xingdeshoumin/darts_-v1.2/README.assets/1815493-20191011175632763-327473720.png

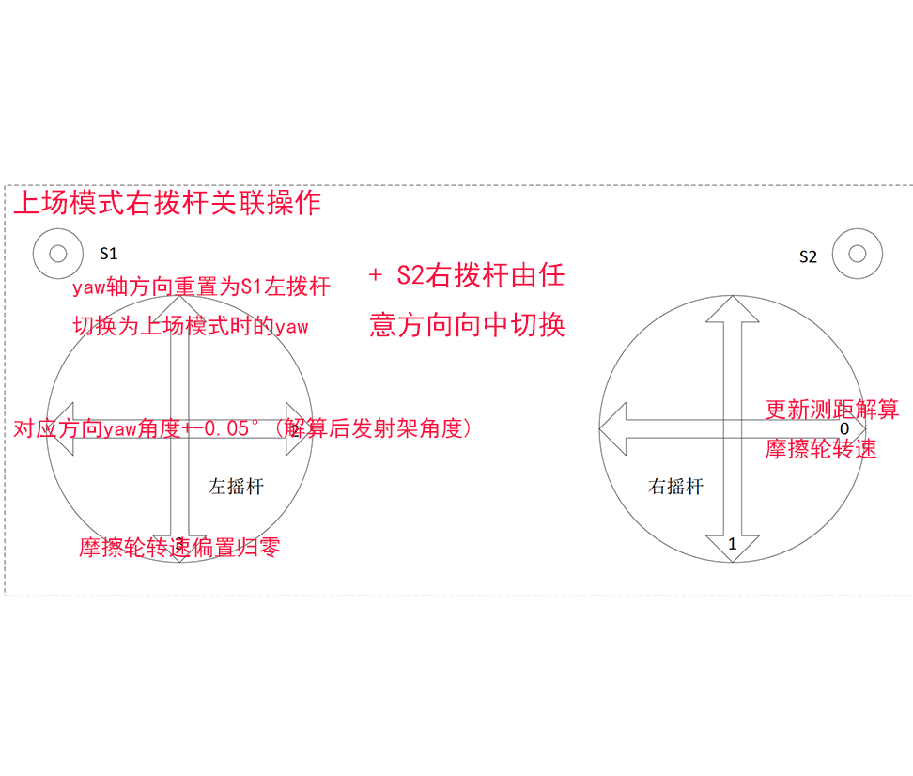
README.assets/1815493-20191011175632763-327473720.png
