xingdeshoumin/darts_-v1.2/updatelogs.assets/IMG_0369.jpeg

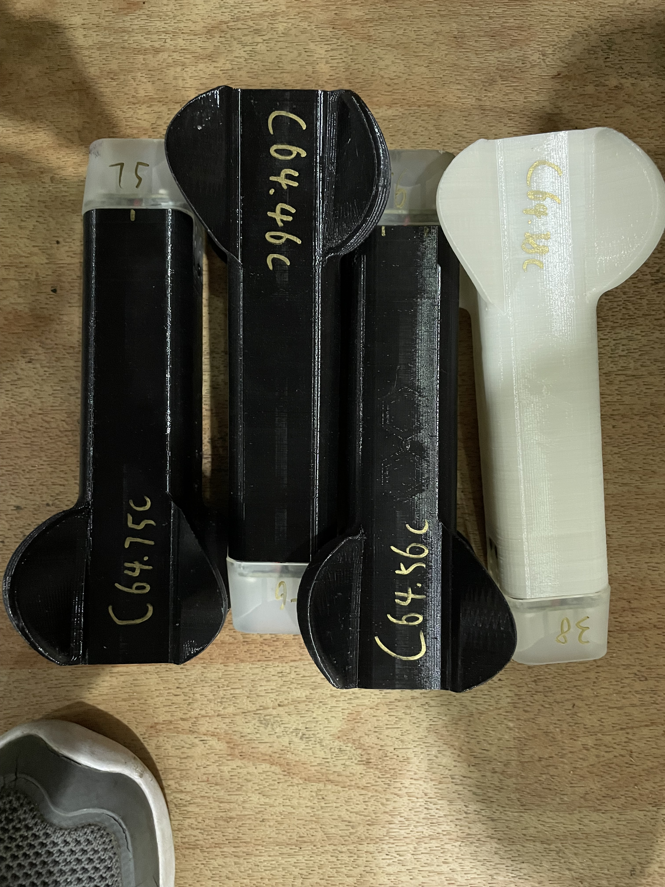
updatelogs.assets/IMG_0369.jpeg
