xingdeshoumin/darts_-v1.2/DARTS_V1.0.ioc

Mcu.UserName=STM32F427IIHx
PA13.Signal=SYS_JTMS-SWDIO
PA14.Signal=SYS_JTCK-SWCLK
PA7.Signal=SPI1_MOSI
PB10.Signal=GPIO_Output
PB3.Signal=SPI1_SCK
PB5.Signal=S_TIM3_CH2
PB6.Signal=USART1_TX
PB7.Signal=USART1_RX
PB8.GPIO_Label=IMU_INT
PB8.Signal=GPXTI8
PB9.Signal=GPIO_Output
PC10.Signal=SDIO_D2
PC11.Signal=SDIO_D3
PC12.Signal=SDIO_CK
PC8.Signal=SDIO_D0
PC9.Signal=SDIO_D1
PD0.Signal=CAN1_RX
PD1.Signal=CAN1_TX
PD2.Signal=SDIO_CMD
PD8.Signal=USART3_TX
PD9.Signal=USART3_RX
PE11.Signal=GPIO_Output
PE7.Signal=UART7_RX
PE8.Signal=UART7_TX
PF0.Signal=GPIO_Output
PF1.Signal=GPIO_Output
PF10.Signal=GPIO_Output
PF14.Signal=GPIO_Output
PF6.Signal=GPIO_Output
PF7.Signal=SPI5_SCK
PF8.Signal=SPI5_MISO
PF9.Signal=SPI5_MOSI
PG1.Signal=GPIO_Output
PG13.Signal=GPIO_Output
PG14.Signal=USART6_TX
PG2.Signal=GPIO_Output
PG3.Signal=GPIO_Output
PG4.Signal=GPIO_Output
PG5.Signal=GPIO_Output
PG6.Signal=GPIO_Output
PG7.Signal=GPIO_Output
PG8.Signal=GPIO_Output
PG9.Signal=USART6_RX
PH0/OSC_IN.Signal=RCC_OSC_IN
PH1/OSC_OUT.Signal=RCC_OSC_OUT
PH2.Signal=GPIO_Output
PH3.Signal=GPIO_Output
PH4.Signal=GPIO_Output
PH5.Signal=GPIO_Output
PI2.Signal=GPXTI2
PI9.Signal=GPIO_Output
