xingdeshoumin/darts_-v1.2/Packages/control/chassis_control.c

#include "chassis_control.h"
#include "string.h"
#include "chassis_behavior.h"
#include "bsp_dubs.h"
#include "STMGood.h"
#include "math.h"
#include "target_finder.h"

float F_P=10,F_I=6.0,F_D=0.5;//摩擦轮PID P：6~10
float F_F=0.012; // 摩擦轮前馈
float YAW_F = 0.1; // yaw前馈
float tmp_correct;


s_pid_absolute_t  MOTOR_S_PID= {0};
s_pid_absolute_t  MOTOR_P_PID = {0};

s_pid_absolute_t  YAW_S_PID= {0};
s_pid_absolute_t  YAW_P_PID = {0};

s_pid_absolute_t  PITCH_S_PID= {0};
s_pid_absolute_t  PITCH_P_PID = {0};

s_pid_absolute_t  FIRE_L_S_PID= {0};

s_pid_absolute_t  FIRE_R_S_PID= {0};

s_pid_absolute_t  DEVIATION_PID= {0};

motor_data_t motor = {0};
motor_data_t yaw = {0};
motor_data_t pitch = {0};
motor_data_t fire_r = {0};
motor_data_t fire_l = {0};

int16_t deviation_out = 0;

void chassis_control_loop_init(void)
{
  	memset(&motor , 0 ,sizeof(motor_data_t));
	memset(&pitch , 0 ,sizeof(motor_data_t));
	memset(&yaw , 0 ,sizeof(motor_data_t));
	memset(&fire_l , 0 ,sizeof(motor_data_t));
	memset(&fire_r , 0 ,sizeof(motor_data_t));
	
	pid_abs_param_init(&MOTOR_S_PID,0,0,0,20000.0f,16000.0f);
	pid_abs_param_init(&MOTOR_P_PID,0,0,0,0.0f,4000.0f);
	
	pid_abs_param_init(&PITCH_S_PID,0,0,0,20000.0f,16000.0f);
	pid_abs_param_init(&PITCH_P_PID,0,0,0,0.0f,4000.0f);
	
	pid_abs_param_init(&YAW_S_PID,0,0,0,20000.0f,28000.0f);
	pid_abs_param_init(&YAW_P_PID,0,0,0,0.0f,400.0f);
	
	pid_abs_param_init(&FIRE_L_S_PID,0,0,0,20000.0f,16000.0f);

	pid_abs_param_init(&FIRE_R_S_PID,0,0,0,20000.0f,16000.0f);

	pid_abs_param_init(&DEVIATION_PID,0,0,0,20000.0f,28000.0f);
}

void chassis_control_loop_reset(void)
{ 
	
	pid_abs_param_init(&MOTOR_S_PID,13,0,0,3000.0f,8000.0f);
	pid_abs_param_init(&MOTOR_P_PID,0.8,0.01,0,0.0f,4000.0f);
	
	pid_abs_param_init(&PITCH_S_PID,9,0.3,0,20000.0f,16000.0f);
	pid_abs_param_init(&PITCH_P_PID,0.5,0.1,0,0.0f,4000.0f);
	
	pid_abs_param_init(&YAW_S_PID,60,10,0,20000.0f,28000.0f);
	pid_abs_param_init(&YAW_P_PID,5,80,0,0.0f,28000.0f);
    // pid_abs_param_init(&YAW_P_PID,5,0,0,0.0f,28000.0f);
	
	pid_abs_param_init(&FIRE_L_S_PID,F_P,F_I,F_D,20000.0f,16000.0f);

	pid_abs_param_init(&FIRE_R_S_PID,F_P,F_I,F_D,20000.0f,16000.0f);
	
	pid_abs_param_init(&DEVIATION_PID,60,0,0,20000.0f,28000.0f);
}


void chassis_motor_control_loop_pid_control(void)
{
	// YL.num += YL_error_correction(YL.num);
	YL.num = fmaxf(YL.num, (-9.71 * REDUCTION_RATIO_WHEEL / 360.0f * 8192.0f + GIMBAL_OFFSET));
	YL.num = fminf(YL.num, (10.61 * REDUCTION_RATIO_WHEEL / 360.0f * 8192.0f + GIMBAL_OFFSET));
	// tmp_correct = FL_error_correction();

	motor.target_position = LL.num;
	pitch.target_position = PL.num;
	yaw.target_position = YL.num;
	fire_l.target_speed = FL.V + tmp_correct;
	fire_r.target_speed = -FL.V - tmp_correct;
	
	MOTOR_P_PID.NowError = motor.target_position - motor.serial_position;
	PITCH_P_PID.NowError =pitch.target_position - pitch.serial_position;

    yaw.filted_position = (1.0f - POSITION_SMOOTH_COEF) * yaw.filted_position + POSITION_SMOOTH_COEF * yaw.serial_position;

	YAW_P_PID.NowError = yaw.target_position - yaw.filted_position;

    fire_l.average_speed = (1.0f - SPEED_SMOOTH_COEF) * fire_l.average_speed + SPEED_SMOOTH_COEF * fire_l.esc_back_speed;
    fire_r.average_speed = (1.0f - SPEED_SMOOTH_COEF) * fire_r.average_speed + SPEED_SMOOTH_COEF * fire_r.esc_back_speed;
    
	FIRE_L_S_PID.NowError = fire_l.target_speed - fire_l.average_speed;
	FIRE_R_S_PID.NowError = fire_r.target_speed - fire_r.average_speed;
	
	PID_AbsoluteMode(&MOTOR_P_PID);
	PID_AbsoluteMode(&PITCH_P_PID);
	PID_AbsoluteMode(&YAW_P_PID);
	
	PID_AbsoluteMode(&FIRE_L_S_PID);
	PID_AbsoluteMode(&FIRE_R_S_PID);
	
	MOTOR_S_PID.NowError = MOTOR_P_PID.PIDout - motor.esc_back_speed;
	PITCH_S_PID.NowError = PITCH_P_PID.PIDout - pitch.esc_back_speed;
	YAW_S_PID.NowError = YAW_P_PID.PIDout - yaw.esc_back_speed;
	
	PID_AbsoluteMode(&MOTOR_S_PID);
	PID_AbsoluteMode(&PITCH_S_PID);
	PID_AbsoluteMode(&YAW_S_PID);
	
	motor.out_current = MOTOR_S_PID.PIDout;
	pitch.out_current = PITCH_S_PID.PIDout;
	yaw.out_current = YAW_S_PID.PIDout;
	fire_l.out_current = FIRE_L_S_PID.PIDout + F_F * fire_l.target_speed;
	fire_r.out_current = FIRE_R_S_PID.PIDout - F_F * fire_r.target_speed;
}

float YL_error_correction(float YL)
{
	static float last_YL;
	static int last_YL_direction_flag;
	static int last_YL_Init_flag;
	static int YL_direction_flag;
	float back_num = 0;

	if (last_YL_Init_flag == 0)
	{
		last_YL = YL;
		last_YL_Init_flag = 1;
	}
	
	if ((YL - last_YL) > 0)
	{
		YL_direction_flag = 1;
	}
	else if ((YL - last_YL) < 0)
	{
		YL_direction_flag = 0;
	}
	if (YL_direction_flag > last_YL_direction_flag)
	{
		back_num = 60.0;
	}
	else if (YL_direction_flag < last_YL_direction_flag)
	{
		back_num = -60.0;
	}
	
	last_YL = YL;
	last_YL_direction_flag = YL_direction_flag;

	return back_num;
}

/*进行摩擦轮补偿的思想是，摩擦轮转速只减不加，由于机械做的十分优秀，在固定温度下给摩擦轮固定转速打出的弹速是一个很标准的正态分布，
（所以这是前提）所以做了这个效果还不错，但是不做纯粹的每个温度对应多少摩擦轮转速的原因是，恒定摩擦轮转速下，温度对应弹速并非是简单一
次线性，所以需要多次测试去整定超参数，为什么要只减不加呢，因为如果做的是完全的线性，那么有可能出现温度降下来后超射速，也造成了每辆车
可能由于机械精度不同，每辆车的公式要重新整定，十分麻烦（毕竟调参要更简单），也可以避免由于机械误差导致弹速不稳定，给了机械一个余量*/

// 猜测温度变化造成转速变化有可能是温度上升导致霍尔编码器灵敏度增高， 返回速度略微增大， 经过环路计算后， 实际转速减小
float FL_error_correction(void)
{
    // float return_num = (40.0f - (fire_l.esc_back_temperature + fire_r.esc_back_temperature) * 0.5f) / 15.0f * 50.0f;
    float return_num = ((fire_l.esc_back_temperature + fire_r.esc_back_temperature) * 0.5f - 29.0f) / 6.0f * 30.0f;
	return_num = fminf(return_num, 120.0f);
	return_num = fmaxf(return_num, -120.0f);
	return return_num;
}
