xingdeshoumin/darts_-v1.2/Packages/Free_Task/motorTask.c

////////////////////////////////////////////////////////////////
//2022.6.16更新
//飞镖问题及优化方向：1.摩擦轮脱胶 2.摩擦轮温度对飞镖速度的闭环没做 
//3.没做数据存储与应用（flash等） 4.飞镖架稳定性（摩擦轮除抖等）
//5.yaw轴小齿大齿周向增设预紧力消除减小齿隙 6.飞镖做开关及充电口
////////////////////////////////////////////////////////////////
// 15962
// 25439

#include "cmsis_os.h"
#include "chassis_control.h"
#include "chassis_behavior.h"
#include "bsp_can.h"
#include "bsp_dubs.h"
#include "bsp_flash.h"


void Startmotor_task(void const * argument)
{
  /* USER CODE BEGIN Startmotor_task */

	chassis_control_loop_init();
  /* Infinite loop */
	
	osDelay(6000);//等can中断
	// 6020返值bug
	YL.num=yaw.serial_position*1.0f;
	LL.num=motor.serial_position*1.0f;
	PL.num=pitch.esc_back_position*1.0f;

	// uint32_t *message;
	// flash_read(0x080E000,message,2);
	
  	for(;;)
	{
		chassis_control_loop_reset(); //配置pid
		rc_to_task();//遥控器键位功能任务
		chassis_motor_control_loop_pid_control();//计算返回电机输出电流
		// CAN_cmd_chassis(motor.out_current,pitch.out_current);
		// CAN_cmd_yaw(yaw.out_current,yaw.out_current);

		
		
		if(flag_zero_all==1)
		{
			CANTx_SendCurrent(&hcan1,0x200,0,0,0,0);
			CANTx_SendCurrent(&hcan1,0x1FF,0,0,0,0);

		}
		else if(flag_zero==1)
		{
			// CANTx_SendCurrent(&hcan1,0x200,motor.out_current,0,pitch.out_current,0);
			CANTx_SendCurrent(&hcan1,0x200,motor.out_current,0,0,0);
			CANTx_SendCurrent(&hcan1,0x1FF,0,yaw.out_current,0,0);
            // CANTx_SendCurrent(&hcan1,0x1FF,0,0,0,0);

		}
		else
		{
			// CANTx_SendCurrent(&hcan1,0x200,motor.out_current,fire_l.out_current,pitch.out_current,fire_r.out_current);
			CANTx_SendCurrent(&hcan1,0x200,motor.out_current,fire_l.out_current,0,fire_r.out_current);
			CANTx_SendCurrent(&hcan1,0x1FF,0,yaw.out_current,0,0);
            // CANTx_SendCurrent(&hcan1,0x1FF,0,0,0,0);
		}
		
		
		osDelay(1);
	
  	}
  /* USER CODE END Startmotor_task */
}
