xingdeshoumin/darts_-v1.2/Packages/bsp/bsp_io.c

#include "bsp_io.h"
#include "gpio.h"

void io_init(void)
{
	HAL_GPIO_WritePin(GPIOH, GPIO_PIN_2, GPIO_PIN_SET);
	HAL_GPIO_WritePin(GPIOH, GPIO_PIN_3, GPIO_PIN_SET);
	HAL_GPIO_WritePin(GPIOH, GPIO_PIN_4, GPIO_PIN_SET);
	HAL_GPIO_WritePin(GPIOH, GPIO_PIN_5, GPIO_PIN_SET);
	HAL_GPIO_WritePin(GPIOG, GPIO_PIN_1, GPIO_PIN_SET);

	HAL_GPIO_WritePin(GPIOG, GPIO_PIN_2, GPIO_PIN_SET);
	HAL_GPIO_WritePin(GPIOG, GPIO_PIN_3, GPIO_PIN_SET);
	HAL_GPIO_WritePin(GPIOG, GPIO_PIN_4, GPIO_PIN_SET);
	HAL_GPIO_WritePin(GPIOG, GPIO_PIN_5, GPIO_PIN_SET);
	HAL_GPIO_WritePin(GPIOG, GPIO_PIN_6, GPIO_PIN_SET);
	HAL_GPIO_WritePin(GPIOG, GPIO_PIN_7, GPIO_PIN_SET);
	HAL_GPIO_WritePin(GPIOG, GPIO_PIN_8, GPIO_PIN_SET);

	HAL_GPIO_WritePin(GPIOF, GPIO_PIN_14, GPIO_PIN_SET);
	HAL_GPIO_WritePin(GPIOE, GPIO_PIN_11, GPIO_PIN_SET);
}

void led_show(uint8_t num)
{
	switch (num)
	{
	case 0:
		HAL_GPIO_WritePin(GPIOG, GPIO_PIN_1, GPIO_PIN_SET);
		HAL_GPIO_WritePin(GPIOG, GPIO_PIN_2, GPIO_PIN_SET);
		HAL_GPIO_WritePin(GPIOG, GPIO_PIN_3, GPIO_PIN_SET);
		HAL_GPIO_WritePin(GPIOG, GPIO_PIN_4, GPIO_PIN_SET);
		HAL_GPIO_WritePin(GPIOG, GPIO_PIN_5, GPIO_PIN_SET);
		HAL_GPIO_WritePin(GPIOG, GPIO_PIN_6, GPIO_PIN_SET);
		HAL_GPIO_WritePin(GPIOG, GPIO_PIN_7, GPIO_PIN_SET);
		HAL_GPIO_WritePin(GPIOG, GPIO_PIN_8, GPIO_PIN_SET);
		break;
	case 1:
		HAL_GPIO_WritePin(GPIOG, GPIO_PIN_1, GPIO_PIN_RESET);
		HAL_GPIO_WritePin(GPIOG, GPIO_PIN_2, GPIO_PIN_SET);
		HAL_GPIO_WritePin(GPIOG, GPIO_PIN_3, GPIO_PIN_SET);
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
{
	switch (color)
	{
	case 0:
		HAL_GPIO_WritePin(GPIOF, GPIO_PIN_14, GPIO_PIN_RESET);
		HAL_GPIO_WritePin(GPIOE, GPIO_PIN_11, GPIO_PIN_SET);
		break;
	
	case 1:
		HAL_GPIO_WritePin(GPIOF, GPIO_PIN_14, GPIO_PIN_SET);
		HAL_GPIO_WritePin(GPIOE, GPIO_PIN_11, GPIO_PIN_RESET);
		break;
	}
}
