xingdeshoumin/darts_-v1.2/Packages/bsp/bsp_PWM.h

/*
 * @Author: kaqi
 * @Date: 2022-09-27 22:07:06
 * @version: 
 * @description: 
 */
/**
  ******************************************************************************
  * @file	 bsp_PWM.h
  * @author  Wang Hongxi
  * @version V1.0.0
  * @date    2020/3/1
  * @brief   
  ******************************************************************************
  * @attention
  *
  ******************************************************************************
  */
#ifndef __BSP_IMU_PWM_H
#define __BSP_IMU_PWM_H

#include "stdint.h"
#include "tim.h"

void TIM_Set_PWM(TIM_HandleTypeDef *tim_pwmHandle, uint8_t Channel, uint16_t value);

#endif
