xingdeshoumin/darts_-v1.2/(commit log)

2023-04-03 修改转速调整方式因为遥控器坏了
2023-04-07 添加mpu6500驱动
2023-04-19 添加INS_task 修改摩擦轮pid参数
2023-05-01 调整yaw轴pid参数
2023-05-05 调试完毕
2023-05-09 添加测距仪驱动
2023-05-10 添加target_finder
2023-05-11 添加拨轮操纵target_finder
2023-05-15 添加温度补偿但未校准
2023-05-17 添加弹道实测数据， 修改上场模式操作
2023-05-17 增加上场模式遥控器yaw控制
2023-05-17 添加操作说明
2023-05-20 更新说明
2023-05-20 更新说明图片
2023-05-22 更新README
2023-05-25 上场程序初版
2023-07-23 新飞镖完成弹道校准
2023-08-03 增加发射暂停， 修订操作说明
2023-08-08 修改零电流切换造成的误差
2023-08-08 默认遥控器拨杆位置bug
2023-08-08 更改基地测距方式
2023-08-09 修远古bug
2023-08-10 修改前的copy
2023-08-26 更新完整updatelogs
