xingdeshoumin/darts_-v1.2/(notices)

Notices in the files:
Core/Src/main.c:
© Copyright (c) 2021 STMicroelectronics.
All rights reserved.
This software component is licensed by ST under Ultimate Liberty license
